ChristianHirsch/SoilMeasuringBoard/README.md

# SoilMeasuringBoard

Schematic of soil measuring node
