ChristianHirsch/SoilMeasuringBoard/SoilMeasuringBoard.kicad_pcb

## KiCad design SoilMeasuringBoard.kicad_pcb (2019-05-31)

Schematic: SoilMeasuringBoard.sch

Parts:
C5: 1u; C_0603_1608Metric
C6, C7: 1n; C_0603_1608Metric
C8: 0.1u; C_0603_1608Metric
D3: LED; LED_0603_1608Metric
D4, D5: BAT54; D_SOD-323
J3: Conn_01x07; PinHeader_1x07_P2.54mm_Vertical
R4: 47; R_0603_1608Metric
R6: 330; R_0603_1608Metric
R7, R8, R9, R10: 1M; R_0603_1608Metric
R11: 4.7k; R_0603_1608Metric
R12, R13, R14: 100k; R_0603_1608Metric
U1: RFD77101; RFDigital_RFD77101
U4: DS18B20U; MSOP-8_3x3mm_P0.65mm
U5: SST26VF016B; SOIC-8_3.9x4.9mm_P1.27mm

Connections:
/BATT_V: U1.21; also elsewhere on the board
/BATT_V_EN: U1.12; also elsewhere on the board
/EXCITATION: R6.2, U1.27
/GPIO0: J3.6, U1.25
/GPIO1: J3.7, U1.23
/LED_1_I: D3.2, U1.31
/LED_1_O: R4.2, U1.32
/SENSE_EN: R7.1, R9.1, U1.26
/SENSE_HIGH: C7.1, D5.1, R9.2, R10.1, U1.22
/SENSE_LOW: C6.1, D4.2, R7.2, R8.1, U1.24
/SENSE_TRACK: D4.1, D5.2, R6.1; also elsewhere on the board
/SPI_MISO: U1.37, U5.2
/SPI_MOSI: U1.33, U5.5
/SPI_SCK: U1.34, U5.6
/SPI_SS: R14.2, U1.38, U5.1
/SWDCLK: J3.5, U1.9
/SWDIO/RESET: J3.4, U1.8
/TEMP_DATA: R11.1, U1.29, U4.1
/TEMP_EN: R11.2, U1.28
GND: C5.2, C6.2, C7.2, C8.2, J3.1, R8.2, R10.2, U1.1, U1.2, U1.4, U1.6, U1.19, U1.30, U1.42, U1.43, U1.44, U1.45, U4.4, U4.8, U5.4; also elsewhere on the board
unnamed: D3.1, R4.1
unnamed: R12.2, U5.7
unnamed: R13.2, U5.3
VBUS: J3.3; also elsewhere on the board
VDD: C5.1, C8.1, R12.1, R13.1, R14.1, U1.7, U5.8; also elsewhere on the board

Schematic: power_mgmt.sch

Parts:
C1, C2: 4.7u; C_0603_1608Metric
C3, C4: 1u; C_0603_1608Metric
D1, D2: BAT20J; D_SOD-323
J1: USB_B_Micro; USB_Micro-B_Molex_47346-0001
J2: BATT_CONN; JST_PH_S2B-PH-K_1x02_P2.00mm_Horizontal
Q1: Q_NMOS_GSD; SOT-23
Q2, Q3: DMP3099L-13; SOT-23
R1: 3.1k; R_0603_1608Metric
R2: 8.2k; R_0603_1608Metric
R3, R5: 10k; R_0603_1608Metric
U2: MCP73811T-420I-OT; SOT-23-5
U3: TLV74130; SOT-23-5

Connections:
+BATT: C2.1, J2.1, Q2.3, Q3.2, R5.1, U2.3 (VBAT)
/BATT_V: R1.2, R2.1; also elsewhere on the board
/BATT_V_EN: Q1.1; also elsewhere on the board
GND: C1.2, C2.2, C3.2, C4.2, J1.5, J2.2, Q1.2, R2.2, R3.2, U2.2 (VSS), U3.2 (GND); also elsewhere on the board
unnamed: C1.1, D1.2, J1.1, U2.1 (CEN), U2.4 (VDD), U2.5 (PROG)
unnamed: C3.1, D2.1, Q2.2, U3.1 (VIN), U3.3 (EN)
unnamed: Q1.3, Q3.1, R5.2
unnamed: Q3.3, R1.1
VBUS: D1.1, D2.2, Q2.1, R3.1; also elsewhere on the board
VDD: C4.1, U3.5 (VOUT); also elsewhere on the board

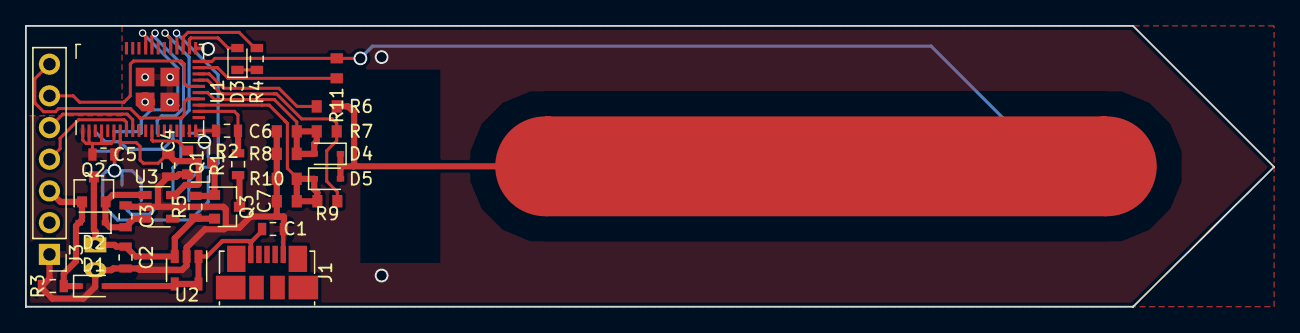
[picture p1: board SoilMeasuringBoard.kicad_pcb from above]

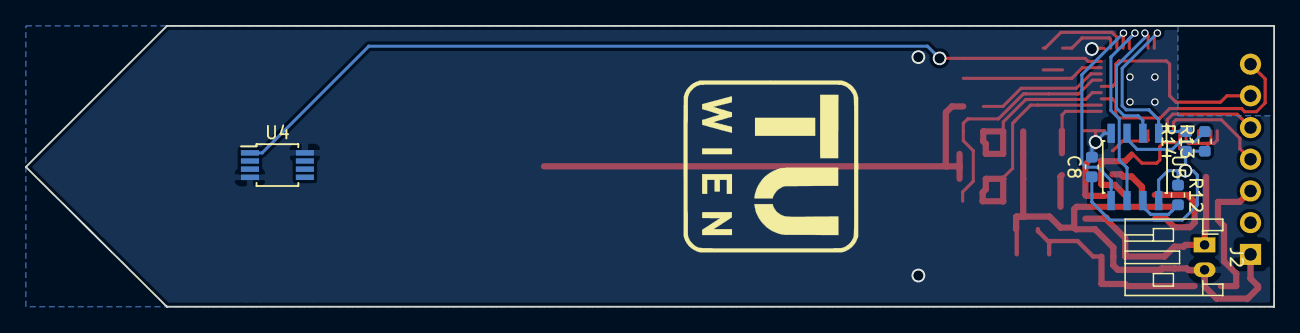
[picture p2: board SoilMeasuringBoard.kicad_pcb from below]

Board: 2 copper layers, 100.0 x 22.5 mm, 39 parts (7 on the bottom side), 30 nets.

Other parts of the board:
C***: SENSE; c_layout_1

Their connections:
/SENSE_TRACK: C***.1; also elsewhere on the board
