ChristianHirsch/SoilMeasuringBoard/(threads)

Thread 1 (2017-10-03):

measure battery level

ChristianHirsch, 2017-10-03:
For outdoor use, it is necessary to measure the battery level. Additionally it shall be possible to enable/disable battery measurements.

ChristianHirsch, 2017-12-07:
fixed

Closed 2017-12-07.

Thread 2 (2017-10-03):

enable/disable soil moisture measuring

ChristianHirsch, 2017-10-03:
It shall be possible to enable/disable the circuit which does the soil moisture measurement to save energy.

ChristianHirsch, 2017-12-07:
fixed

Closed 2017-12-07.

Thread 3 (2017-12-07):

p mosfet (soil sensor) wiring problem

ChristianHirsch, 2017-12-07:
the p mosfet which switches the capacitive sensor is wired wrongly.

ChristianHirsch, 2017-12-07:
fixed (y)

Closed 2017-12-07.
