ChristianHirsch/SoilMeasuringBoard/(commit log)

2017-06-30 initial commit
    add basic kicad files for the soil measuring board
    [CapacitiveSoilSensor.sch, PowerMgmt.sch, soilsensor.kicad_pcb, soilsensor.sch]
2017-06-30 fix missing regulator, add power mgmt lib
    [CapacitiveSoilSensor.sch, PowerMgmt.sch, soilsensor.sch]
2017-06-30 update power management
    - add battery connector
    - remove unnecessary filter
    [PowerMgmt.sch]
2017-07-03 add coil sensor layout and footprint
    coil = Capacitive sOIL
2017-07-03 fix minors, make annotations
    [CapacitiveSoilSensor.sch, PowerMgmt.sch, soilsensor.sch]
2017-07-04 add measuring capacitor
    [CapacitiveSoilSensor.sch]
2017-07-04 update footprints
    [CapacitiveSoilSensor.sch, PowerMgmt.sch, soilsensor.sch]
2017-07-04 add pcb file
    [soilsensor.kicad_pcb]
2017-07-06 update capacitive soil sensor layout
2017-07-06 working on pcb
    [soilsensor.kicad_pcb]
2017-07-19 update capacitive soil measuring sensor
2017-07-19 finish pcb
    [soilsensor.kicad_pcb, soilsensor.sch]
2017-08-01 easier power mgmt
    use MAX1811 chip
    [PowerMgmt.sch]
2017-08-01 a lot of fixes, finished one-sided layout
    [CapacitiveSoilSensor.sch, soilsensor.kicad_pcb, soilsensor.sch]
2017-08-23 update sensor
    [CapacitiveSoilSensor.sch, PowerMgmt.sch, soilsensor.kicad_pcb, soilsensor.sch]
2017-10-11 improve power mgmt schematics
    [PowerMgmt.sch]
2017-10-11 add enable line for cap. sensor
    [CapacitiveSoilSensor.sch]
2017-10-11 update schematic for new components
    [soilsensor.sch]
2017-10-11 update pcb for new schematic
    [soilsensor.kicad_pcb]
2017-10-11 fix power mgmt
    [PowerMgmt.sch]
2017-10-11 fix cap. soil sensor
    [CapacitiveSoilSensor.sch]
2017-10-11 minors in schematic
    rewiring etc.
    [soilsensor.sch]
2017-10-11 create new one-sided pcb
    [soilsensor.kicad_pcb]
2017-10-16 add bom file
    [bom.csv]
2017-10-16 change mosfet layouts
    [CapacitiveSoilSensor.sch, PowerMgmt.sch]
2017-10-16 add footprints to new mosfets
    [CapacitiveSoilSensor.sch, PowerMgmt.sch]
2017-10-16 update pcb with new mosfets
    [soilsensor.kicad_pcb]
2017-10-16 update total cost in bom file
    [bom.csv]
2017-11-07 update power mgmt
    [PowerMgmt.sch]
2017-11-07 update bom
    [bom.csv]
2017-11-07 update schematics
    [soilsensor.sch]
2017-11-07 update pcb
    [soilsensor.kicad_pcb]
2017-11-07 add new layout for soil measuring capacity
2017-12-07 fix #3: rewire p mosfet to swicht c-sensor
    [CapacitiveSoilSensor.sch, soilsensor.kicad_pcb]
2018-04-17 update houding, add new capacitive layout
    [housing.scad]
2018-04-17 cleanup for new version
    [CapacitiveSoilSensor.sch, PowerMgmt.sch, bom.csv, soilsensor.kicad_pcb, soilsensor.sch]
2018-08-01 pre-flash commit
    [SoilMeasuringBoard.kicad_pcb, SoilMeasuringBoard.sch, power_mgmt.sch]
2018-08-01 add flash memory
    [SoilMeasuringBoard.kicad_pcb, SoilMeasuringBoard.sch]
2018-11-08 update README w/ schematic
2019-05-31 final fixes
    [SoilMeasuringBoard.kicad_pcb]
